panhandle76/sam-fusee-launcher-internal/(commit log)

2018-06-25 add short green light for success
    [main.ino]
2018-07-02 Update Hekate to 3.0. Move interrupt to hold RCM_STRAP immediately after pin goes up when coming from any state. Added option for Vol+ control. Updated documentation for alternate wakeup and RCM_STRA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
